FriasCamille/proyecto_final_invernadero/README.md

# Proyecto final Fundamentos de Sistemas Embebidos 2025-1
 proyecto_final_invernadero
# Universidad Nacional Autónoma de México
## Facultad de Ingeniería
 Grupo: 02
# Autores:
- Cruz Calderón Jorge Luis
- Frías Hernández Camille Emille Román
- Sánchez Estrada Angel Isaac
