FriasCamille/proyecto_final_invernadero/log/Proyecto_Final_Invernadero.pdf

# Proyecto final Control de invernadero

Cruz Calderón Jorge Luis, Frías Hernández Camille Emille Román, Sánchez Estrada Angel Isaac

El presente proyecto busca gestionar de manera eficiente las condiciones internas del entorno controlado, asegurando la regulación de temperatura, la irrigación y el flujo de aire, mediante la integración de sensores y actuadores.

El sistema contará con funciones automatizadas, como el encendido y apagado del sistema de irrigación, el control de temperatura a través de un controlador PID, y la administración de la velocidad del ventilador mediante señales PWM. Adicionalmente, se implementará un servidor web que permitirá el acceso remoto a las funciones del invernadero y la consulta de gráficas históricas que registran las variables monitoreadas y las acciones realizadas.

El proyecto incluye tanto el diseño de hardware, que comprende la conexión de sensores y actuadores, como el desarrollo de software para la programación del sistema embebido, garantizando una solución práctica, robusta y accesible para usuarios con conocimientos básicos en electrónica y sistemas embebidos.

## 1. Objetivos

Diseñar e implementar un sistema embebido que permita la supervisión y control remoto de un invernadero más enfocado en las plantas suculentas, integrando sensores y actuadores para gestionar de manera precisa las variables ambientales internas.

Desarrollar una solución de software y hardware que incorpore un controlador PID para regular la temperatura, así como señales PWM para administrar la velocidad del ventilador, asegurando un funcionamiento eficiente y confiable.

Proveer un sistema de visualización de datos históricos mediante gráficas almacenadas, además de un servidor web local, para facilitar el análisis y la toma de decisiones sobre el funcionamiento del invernadero.

## 2. Antecedentes

Adaptabilidad y Eficiencia de las Suculentas en Espacios Reducidos: Diseño y Gestión de un Invernadero Controlado

En este proyecto se plantea usar la planta suculenta debido a los cuidados que requiere, ya que se ca-racteriza por su bajo consumo de recursos, tanto naturales como de mantenimiento. Esta elección resulta particularmente adecuada para un entorno de estudiante o en espacios reducidos, como un departamento, donde el tiempo y los recursos disponibles para el cuidado de plantas suelen ser limitados.

Las suculentas, gracias a su capacidad natural para almacenar agua en sus hojas, tallos o raíces, prosperan con un riego esporádico y no necesitan de un sustrato complejo, lo que facilita su cuidado. Además, estas plantas toleran ambientes con baja humedad relativa, entre el 10 % y el 30 %, y se adaptan fácilmente a invernaderos con condiciones controladas, sin requerir sistemas complicados de irrigación

Página 1 de 32 o ventilación. Estas características las hacen ideales para espacios donde la optimización de recursos es crucial (Nabors, 2006).

El diseño de un invernadero para plantas suculentas debe considerar los aspectos clave de ventilación, irrigación y control de temperatura, ya que estos influyen directamente en su crecimiento.

Las suculentas requieren una iluminación intensa para un crecimiento óptimo. El uso de una lámpara incandescente de 100W proporciona la intensidad lumínica necesaria. Sin embargo, estas lámparas emiten una cantidad significativa de calor, lo que puede dañar las plantas si se colocan demasiado cerca. Por lo que, una lámpara incandescente de 100W puede colocarse a una distancia de 30cm de las plantas, proporcionando la intensidad lumínica adecuada sin el riesgo de sobrecalentamiento (Saltón Verde, 2022).

Las suculentas prosperan en un rango de temperatura diurna de 21°C a 29°C y nocturna de 10°C a 15°C. Es esencial monitorear la temperatura dentro del invernadero, especialmente al utilizar fuentes de luz que emiten calor. El uso de lámparas incandescentes puede elevar la temperatura interna, por lo que es crucial asegurarse de que no exceda los 30°C para evitar el estrés térmico en las plantas (Garvillo, 2023).

Una ventilación adecuada es vital para mantener niveles óptimos de temperatura y humedad, así como para prevenir la acumulación de patógenos. La instalación de dos ventiladores en la parte superior del invernadero ayudará a promover la circulación del aire y a disipar el calor generado por la lámpara. Es recomendable que los ventiladores operen de manera continua o en intervalos regulares para asegurar una renovación constante del aire (Bribiesca, R., 2020).

El método de riego subterráneo es una técnica que suministra agua directamente al sistema radicular mediante emisores enterrados. Este método minimiza pérdidas por evaporación, lo que lo convierte en una opción eficiente para las suculentas, especialmente en ambientes controlados como invernaderos. Al permitir que el agua llegue directamente a las raíces, este sistema evita el desperdicio hídrico, una ventaja significativa en regiones con limitaciones de agua (Lucas et al., 2015).

Protocolos

El bus 1-Wire es un protocolo de comunicación serial desarrollado por Dallas Semiconductor, ahora parte de Maxim Integrated, que permite la interconexión de dispositivos digitales utilizando una única línea de datos y una referencia a tierra común. En una configuración maestro-esclavo, el dispositivo maestro controla la comunicación y puede interactuar con múltiples esclavos, cada uno con una dirección única de 64 bits, lo cual facilita la identificación y el acceso a cada dispositivo en el bus (Linke, 2008).

Por otro lado, el bus I2C, desarrollado por Philips, permite la interconexión de múltiples dispositivos mediante dos líneas, SDA (datos) y SCL (reloj). Este protocolo soporta varios modos de velocidad y puede conectar múltiples dispositivos maestros y esclavos, cada uno identificado por una dirección única de 7 o 10 bits (NXP Semiconductors, 2021).

Componentes

El sensor DS18B20 es un sensor de temperatura digital que utiliza el bus 1-Wire para comunicarse con dispositivos maestros como la Raspberry Pi. Este sensor, que tiene un rango de temperatura de -55°C a +125°C y una precisión de ±0.5°C, se puede alimentar directamente desde la línea de datos, simplificando el diseño del sistema (Maxim Integrated, 2015).

El TRIAC es un dispositivo semiconductor utilizado para controlar flujos de baja potencia en un circuito CA. Los TRIACS pueden conducir en ambos sentidos de la corriente, permitiendo la modulación del ciclo completo de la señal alterna (Boylestad y Nashelsky, 2015).

El IRLZ44N es un transistor MOSFET de canal N diseñado principalmente para aplicaciones de conmutación y control de potencia. Este componente se destaca por su capacidad para manejar altas corrientes de hasta 47 amperios y su baja resistencia en estado de conducción, lo que lo hace eficiente

Página 2 de 32 en términos de disipación de energía. Gracias a su voltaje de umbral bajo, puede ser controlado directamente mediante señales de nivel lógico, lo cual facilita su integración en circuitos digitales (Philips Semiconductors, 1999).

El MOC3021 es un optoacoplador diseñado para aislar eléctricamente circuitos de control de corriente directa y dispositivos de corriente alterna. Este dispositivo emplea un diodo emisor de infrarrojos y un interruptor bilateral de silicio que, juntos, permiten controlar cargas como motores, lámparas o solenoides. Una de sus principales ventajas es su capacidad para bloquear voltajes de hasta 400 voltios, proporcionando un aislamiento seguro de hasta 5300 voltios RMS (Fairchild Semiconductor, 2003).

Por otro lado, los optoacopladores o optoaisladores son dispositivos que permiten la transmisión de señales entre dos circuitos. El dispositivo consta de un LED y un fotodiodo, donde el LED emite luz en señal de entrada activando el fotodiodo de salida. El optoacoplador 4N25 es un dispositivo electrónico ampliamente utilizado que combina un diodo emisor de luz (LED) y un fototransistor NPN en un encapsulado DIP de 6 pines, con el propósito de proporcionar aislamiento eléctrico entre dos circuitos. Entre sus características principales destacan su capacidad de manejar tensiones de colector-emisor de hasta 70 V, así como una corriente de entrada típica de 10 mA para activar el LED interno (Mishra y Singh, 2018; Vishay Semiconductors, 2010).

El sensor de humedad del suelo FC-28 es un dispositivo ampliamente utilizado para medir la humedad en aplicaciones agrícolas, como los sistemas de riego automatizados en invernaderos. Este sensor opera mediante la medición de la conductividad eléctrica entre sus electrodos, la cual varía según el contenido de agua en el suelo. Ofrece tanto una salida analógica como una digital, lo que facilita su integración con microcontroladores. Su implementación permite monitorear continuamente la humedad del suelo, lo que resulta fundamental para optimizar el uso del agua y evitar problemas como el riego excesivo o la deshidratación de las plantas (Marrero Ramírez et al., 2021).

Control de un foco incandescente de 100 W mediante PID

El control PID es ampliamente utilizado para regular dispositivos que requieren precisión, como un foco incandescente de 100 W. Este sistema ajusta la potencia en función de la diferencia entre el valor deseado y el valor medido, minimizando el error actual y acumulado. El control PID ofrece una respuesta dinámica y estable al regular variables como la temperatura, gracias a su capacidad de ajustar automáticamente los parámetros proporcional, integral y derivativo. En este caso, la señal del PID puede controlar un TRIAC para modular gradualmente la intensidad lumínica del foco y, en consecuencia, la temperatura generada (Dorf y Bishop, 2011).

Control de los ventiladores mediante PWM

La Modulación por Ancho de Pulso (PWM) es una técnica eficiente para controlar dispositivos como ventiladores. El PWM permite variar la velocidad de un motor ajustando el ciclo de trabajo de una señal digital, lo que regula la potencia entregada sin pérdidas significativas de energía. En este caso, la frecuencia de la señal debe seleccionarse adecuadamente para evitar ruido y garantizar un funcionamiento suave. Este método se implementa fácilmente mediante un microcontrolador y un transistor o driver de motor, permitiendo ajustar la velocidad del ventilador según los requerimientos del sistema (Rashid, 2013).

## Lista de Componentes

Se asume que el alumno cuenta con una Raspberry Pi con sistema operativo Raspberry Pi OS Lite (2023–05–03 o anterior) e intérprete de Python instalado. Se aconseja encarecidamente el uso de Git como programa de control de versiones.

Dispositivos principales

1 Raspberry Pi Placa Base Modelo B / 8GB

Página 3 de 32

1 microcontrolador RP2040 (Raspberry Pico) con firmware MicroPython precargado

Accesorios y conectividad

1 cable USB-C con soporte para datos

1 conector DIL con cable plano tipo listón para el GPIO de la Raspberry Pi

Cables y conectores varios

10 Borneras de 2

2 Borneras de 3

Alimentación y energía

1 fuente de alimentación regulada a 5V y al menos 2 amperios de salida

1 fuente de alimentación regulada a 12V y al menos 1 amperio de salida

Resistencias

1 resistencia de 68 kΩ (
1
4 Watt)

4 resistencias de 10 kΩ (
1
4 Watt)

1 resistencia de 4.7 kΩ (
1
4 Watt)

1 resistencia de 1 kΩ (1 Watt)

4 resistencias de 470 Ω (
1
4 Watt)

1 resistencia de 330 Ω (
1
4 Watt)

Componentes electrónicos adicionales

1 TRIAC BT137

4 diodos 1N4007 o puente rectificador equivalente

1 optoacoplador 4N25

1 optoacoplador MOC 3021

1 LED ultrabillante de 5 mm

3 transistores IRLZ44

Sistema de ventilación y enfriamiento

2 ventiladores plásticos 510-740 de 4”12V RAD (8x8x2.5 cm)

Sistema de bombeo

1 mini bomba de agua 6-12V (3W, 0.3Mpa)

4 metros de manguera para bomba de agua de 0.9 a 1 cm

Página 4 de 32

Iluminación

1 foco incandescente de 100W (NO AHORRADOR NI LED)

1 socket para foco incandescente

Otros

1 protoboard o circuito impreso equivalente

1 sensor de humedad del suelo FC-28 Higrómetro

4 sensores de temperatura DS18B20

## 3. Descripción del funcionamiento de los componentes

Control del foco

Al estar trabajando con un circuito que requiere una parte en AC y otra en DC, es necesario rectificar la señal. Para ello se utilizaron diodos 1N4007, debido a su capacidad de soportar hasta 1000 V, lo cual es más que suficiente para la señal de AC en México, que es de 120 V. Por otro lado, el amperaje especificado para ellos es de un máximo de 1 A. Al usar un foco de 100 W y despejar de la fórmula I =

P
V

, obtenemos
un resultado de menos de un amperio, 0,833, por lo que estos diodos son ideales para la rectificación de esta señal.

Se utiliza un TRIAC (Triode for Alternating Current) que permite conmutar el paso de la corriente en un circuito de AC. En este caso, este circuito enciende el foco, cumpliendo la función de un interruptor, similar a un transistor en DC o a un relé, pero con la ventaja de ser más duradero y de poder funcionar con una señal de un microcontrolador, incluso con una corriente muy pequeña, permitiendo su activación controlada.

Con el fin de aislar correctamente las señales de AC y DC, se utilizaron dos optoacopladores: el 4N25 y el MOC3021. De esta forma, podemos detectar el cruce por cero de la señal rectificada. Asimismo, se puede enviar una señal al tiristor para activarlo y permitir el paso de la corriente al foco. El MOC3021 fue utilizado por tener un tiristor interno que le permite manejar los cambios de fase de una señal de AC sin perjudicar su funcionamiento, de forma que puede mandar una pequeña señal de AC al TRIAC, que manejará la señal directa de AC. Por su parte, el 4N25, al tener un circuito simple con un LED y un fototransistor, permite que el microcontrolador pueda detectar cada vez que el LED se apague, lo cual indica que la señal ha pasado por cero.

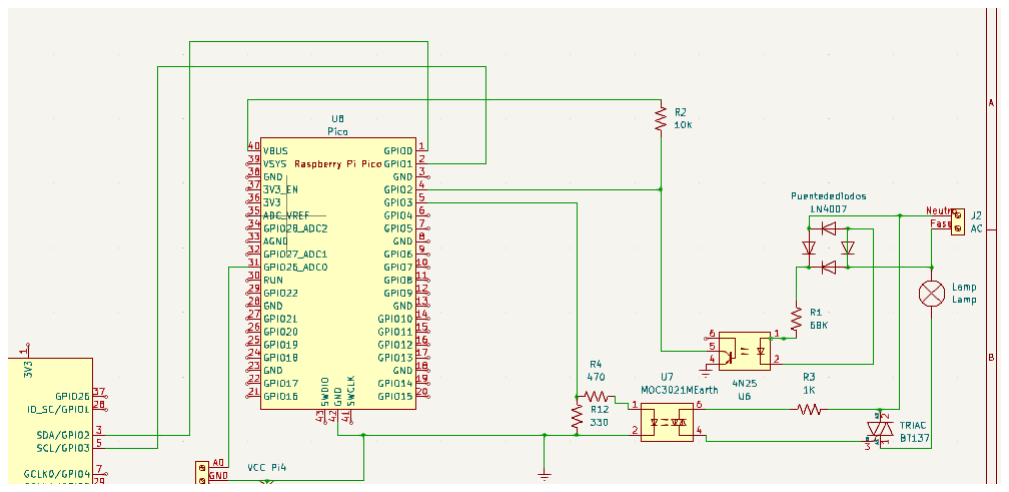
[picture p1: figure]

Figura 1: Circuito de control de foco

Control de motores

Los motores son actuadores que requieren una gran corriente para vencer la inercia y comenzar su trabajo. Con el fin de no exigir demasiado al microcontrolador y evitar dañarlo, se utilizan transistores

Página 5 de 32 en modo interruptor con una fuente externa que pueda satisfacer las necesidades de los actuadores, como amperajes relativamente altos (1 A) y un voltaje diferente al de salida de los microcontroladores.

Para este circuito se utilizaron transistores IRLZ44, ya que los motores de los ventiladores requieren 12 V DC y un amperaje de 220 mA, según la hoja de especificaciones. Por lo tanto, se empleó un transistor en modo interruptor para cada ventilador, así como para la bomba de 12 V y 250 mA. Para proteger al microcontrolador, y aprovechando la capacidad de los transistores de activarse con una señal de bajo amperaje, se utilizó una resistencia de 470 Ω y otra resistencia de 10 kΩ entre el source y el gate para evitar ruido en la señal, asegurando que se apaguen y enciendan según lo deseado.

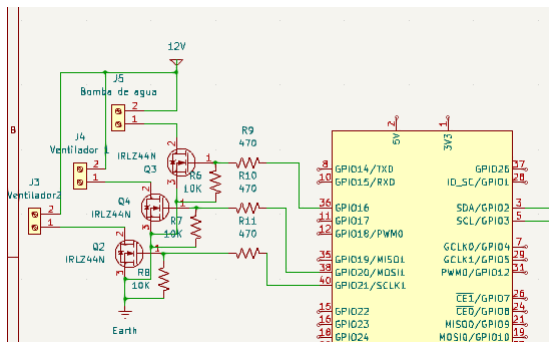
[picture p2: figure]

Figura 2: Circuito del control de los motores

Sensado

El sistema incluye dos tipos principales de sensores: sensores de temperatura y un sensor de humedad.

Los sensores de temperatura son del tipo DS18B20, que operan mediante el protocolo One Wire. Esto permite realizar varias mediciones usando solamente un pin de señal, sin la necesidad de preocuparse por la sincronización de datos ni por la conversión analógica a digital. Estos sensores utilizan una resistencia de 470 Ω conectada a VCC, según lo recomendado en la hoja de datos.

Por su parte, para la medición de humedad se utilizó un higrómetro FC-28, que permite obtener lecturas tanto analógicas como digitales. Esto facilita una mejor aproximación de la humedad dentro del invernadero. Además, su cableado es simple, utilizando únicamente un pin ADC proporcionado por la Pico, obteniendo un porcentaje de humedad útil para decidir el riego.

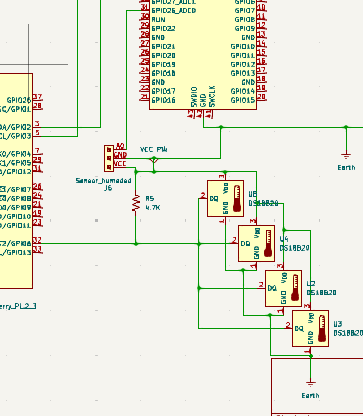
[picture p3: figure]

Figura 3: Circuito del control de los sensores

Página 6 de 32

## 4. Descripción del funcionamiento de la tarjeta controladora y circuito microcontrolador

En este sistema se emplean dos tarjetas: una Raspberry Pi 4 y una Raspberry Pi Pico, cada una con funciones específicas dentro del diseño.

La Raspberry Pi 4 se encarga de ejecutar los procesos principales, incluyendo el cálculo y la activación de los actuadores. Esta tarjeta realiza los cálculos del error y las correcciones correspondientes para el control PID, además de gestionar el sensado de los termómetros mediante el protocolo One Wire. También es responsable de la interfaz gráfica para el servidor, permitiendo la visualización y el control centralizado de la mayoría de las señales del sistema.

Por otro lado, la Raspberry Pi Pico tiene como función principal la gestión de señales críticas enviadas a la Raspberry Pi 4. Esto incluye la detección del cruce por cero en el circuito del foco y el envío de la señal de retorno desde el dimmer al MOC. Gracias a sus puertos ADC, la Raspberry Pi Pico también realiza la medición de los niveles de humedad, proporcionando una señal digital (0 o 1) a la Raspberry Pi 4 para su procesamiento, contribuyendo así al comportamiento automatizado del sistema.

## 5. Cuidado de la salud y advertencias de riesgos

El diseño e implementación de un sistema de invernadero utilizando componentes electrónicos y eléctricos requiere adoptar medidas de seguridad rigurosas para proteger tanto al usuario como al equipo.

En primer lugar, se deben manipular con precaución las fuentes de alimentación y los dispositivos conectados a la corriente eléctrica. Nunca se debe operar con las manos húmedas ni en superficies mojadas, ya que esto aumenta significativamente el riesgo de electrocución. Asimismo, es fundamental utilizar protectores contra sobrecargas para evitar picos de voltaje que puedan dañar el sistema o causar incendios. Los cables y conectores deben revisarse regularmente para garantizar que no presenten desgaste o daño que pueda resultar en cortocircuitos o pérdida de funcionalidad.

El foco incandescente de 100W puede representar un riesgo, ya que alcanza temperaturas elevadas durante su operación. El contacto directo con este elemento puede causar quemaduras graves, y su proximidad a materiales inflamables aumenta el peligro de incendio. Por ello, se debe instalar en un soporte resistente al calor y mantenerlo alejado de otros componentes sensibles al calor, como sensores o cables.

Los sistemas de ventilación y bombeo implican riesgos mecánicos y eléctricos. Los ventiladores en funcionamiento pueden causar lesiones si se tocan accidentalmente, mientras que la bomba de agua, al operar con líquidos, presenta el peligro de cortocircuitos si las conexiones eléctricas no están adecuadamente aisladas de la humedad. Es recomendable utilizar carcasas protectoras para los ventiladores y garantizar que las conexiones eléctricas estén adecuadamente aisladas.

Trabajar con estos dispositivos requiere un entorno limpio, seco y bien ventilado, así como un cono-cimiento básico de las especificaciones técnicas de cada componente. Tener acceso a un interruptor de seguridad para desactivar rápidamente el sistema en caso de emergencia, además de un kit de primeros auxilios, puede ser crucial para abordar cualquier eventualidad.

## 6. Información sobre el cuidado de los componentes electrónicos delicados

El cuidado adecuado de los componentes electrónicos es fundamental para garantizar su correcto funcionamiento y prolongar su vida útil, especialmente en proyectos donde se utilizan dispositivos sensibles como los incluidos en el sistema de invernadero. En primer lugar, es necesario considerar las descargas electrostáticas (ESD), ya que estas representan un riesgo significativo para componentes como la Raspberry Pi y el microcontrolador RP2040. Para mitigar este riesgo, se recomienda trabajar en superficies

Página 7 de 32 antiestáticas, utilizar una pulsera antiestática conectada a tierra y manipular los dispositivos únicamente por los bordes, evitando el contacto directo con pines o terminales expuestos.

Los TRIAC, optoacopladores y transistores requieren un manejo delicado, asegurando siempre que sus terminales estén aislados y protegidos contra picos de corriente. Para ello, se sugiere utilizar fusibles o circuitos de protección adicionales. El sistema de ventilación y bombeo también presenta cuidados específicos. Los ventiladores deben mantenerse libres de polvo y montados de manera firme para evitar vibraciones que puedan dañar otros componentes. Asimismo, la bomba de agua debe operarse con precaución, evitando su funcionamiento en seco y asegurando que las conexiones eléctricas estén debidamente selladas para prevenir filtraciones y cortocircuitos.

El foco incandescente debe mantenerse a una distancia prudente de los componentes electrónicos para evitar daños por exposición al calor. Además, debe evitarse su manipulación mientras está encendido o caliente, debido al riesgo de quemaduras. Por último, el sensor de humedad del suelo FC-28 requiere una limpieza regular para evitar corrosión y debe utilizarse dentro de sus parámetros operativos, evitando inmersiones profundas en agua, ya que podrían dañarlo.

## 7. Configuración de la tarjeta controladora y microcontrolador

Para la configuración de los protocolos de comunicación I2C y One-Wire en la Raspberry Pi, se siguieron los pasos descritos a continuación:

1. Acceder al menú de configuración de la Raspberry Pi utilizando el comando:

sudo raspi-config

2. Dentro del menú de configuración, seleccionar la opción Interface Options.
3. Habilitar el protocolo I2C seleccionando la opción I2C y confirmando su activación.
4. Repetir el proceso para habilitar el protocolo One-Wire seleccionando la opción One-Wire.
5. Guardar los cambios y salir del menú de configuración.
6. Reiniciar la Raspberry Pi para aplicar los cambios ejecutando el comando:

sudo reboot

7. Verificar que los protocolos estén habilitados correctamente:

Para I2C, instalar la utilidad i2c-tools si aún no está instalada:

sudo apt-get install -y i2c-tools

Luego, utilizar el comando:

i2cdetect -y 1

Esto mostrará una tabla con los dispositivos conectados en el bus I2C.

Para One-Wire, verificar la presencia del archivo de dispositivo asociado en el sistema de archivos en la ruta:

/sys/bus/w1/devices

Página 8 de 32

Donde los sensores o dispositivos conectados deberían aparecer listados.

Con estos pasos, los protocolos I2C y One-Wire quedan configurados y listos para su uso en la Raspberry Pi. Esto permite la comunicación con los sensores de temperatura y la Raspberry Pi Pico.

### 7.1. Inicio automático

Para la ejecución automática, se debe acceder nuevamente a la configuración de la Raspberry Pi utilizando el comando:

sudo raspi-config

De ahí se elegirá la opción System Options → Boot/Autologin y seleccionar la opción que mejor se ajuste a las necesidades.

Se reiniciará para guardar las configuraciones y, una vez que vuelva a encender, se creará un archivo bash que ejecutará el archivo del proyecto con un código similar al siguiente:

#!/bin/bash

# Navegar al directorio donde está el archivo final.py cd /ruta/del/programa

# Ejecutar el programa en Python

python3 programa.py

# Fin del script

exit 0

Se le otorgarán permisos de ejecución con:

chmod +x /home/pi/miprograma.sh

Luego, se modificará el archivo rc.local agregando la siguiente línea antes del exit del archivo:

/home/pi/programa.sh

## 8. Desarrollo de los componentes de software

Control del sistema de irrigación y humedad

Cruz Calderón Jorge Luis

Como se investigó en los antecedentes, la planta suculenta es capaz de soportar humedades bajas de alrededor del 10 % y 30 %. Y, en base a esto, se creó la función controlar humedad en la Pico, que gestiona el nivel de humedad mediante la activación o desactivación de una salida según los valores obtenidos del sensor. En primer lugar, evalúa si el porcentaje de humedad es inferior al umbral mínimo (10 %).

Si esta condición se cumple, activa la salida a un estado alto (1) y emite un mensaje indicando que la humedad es baja. En cambio, si la humedad excede el umbral máximo (30 %), desactiva la salida estableciendo un estado bajo (0). Finalmente, si la humedad se encuentra dentro del rango aceptable, la función asegura que la salida permanezca desactivada. De esta forma, el sistema garantiza el control eficiente de la humedad, manteniéndola dentro de los límites especificados para una suculenta.

1 def controlar_humedad ( humedad , pin , min_humedad =10 , max_humedad =30) :

Página 9 de 32

2 | if humedad < min_humedad :
3 | pin . value (1)
4 | print (" Humedad baja . Activando salida ... ")
5 | elif humedad > max_humedad :
6 | pin . value (0)
7 | print (" Humedad alta . Desactivando salida ... ")
8 | else :
9 | print (" Humedad dentro del rango adecuado .")
10 | pin . value (0)

Código 1: Función para el control de humedad

En la Raspberry Pi, la función solve humidity es responsable de gestionar la activación del sistema de irrigación en función de una señal de entrada detectada en el pin denominado PIN INTERRUPT. En primer lugar, verifica si dicho pin se encuentra en un estado alto, indicando la necesidad de iniciar el riego. En este caso, la función activa el pin de salida para habilitar el sistema de irrigación, manteniéndolo encendido durante un segundo utilizando un temporizador o función de retardo. Posteriormente, desactiva el pin de salida para detener la irrigación.

Si, por el contrario, la señal en PIN INTERRUPT está en estado bajo, la función garantiza que el sistema de irrigación permanezca apagado al desactivar el pin de salida. De esta manera, la función asegura un control eficiente y reactivo del riego, basado en las condiciones detectadas por el sensor.

1 | def solve_humidity () :
2 | if GPIO . input ( PIN_INTERRUPT ) == GPIO . HIGH :
3 | GPIO . output ( PIN_OUTPUT , GPIO . HIGH )
4 | print (" I n t e r r u p c i n detectada , PIN 16 en ALTO ")
5 | time . sleep (1)
6 | GPIO . output ( PIN_OUTPUT , GPIO . LOW )
7 | else :
8 | GPIO . output ( PIN_OUTPUT , GPIO . LOW )

Código 2: Función activar la irrigación

Control de temperatura del invernadero utilizando PID a través del foco incandescente

Frías Hernández Camille Emille Román y Sánchez Estrada Angel Isaac ´

El sistema implementa un controlador PID para regular la temperatura del invernadero ajustando la potencia del foco incandescente a través del protocolo I²C.

La clase PIDController es el núcleo del sistema de control proporcional-integral-derivativo (PID). Utiliza la fórmula:

salida = Kp · error + Ki

- integral + Kd · derivada

Donde:

Kp: Coeficiente proporcional.

Ki: Coeficiente integral.

Kd: Coeficiente derivativo.

error: Diferencia entre el setpoint y el valor actual.

integral: Acumulación de errores pasados.

derivada: Cambio del error con respecto al tiempo.

Página 10 de 32 calculate(): Ajusta la potencia del sistema y la limita entre 0 % y 100 %.

1 | def calculate ( self , setpoint , actual_value , dt =3.0) :
2 | error = setpoint - actual_value
3 | self . integral += error * dt
4 | derivative = ( error - self . previous_error ) / dt
5 | output = self . Kp * error + self . Ki * self . integral + self . Kd * derivative
6 | self . previous_error = error
7 | # Limitar salida entre 0 % y 100 %
8 | output = max (0 , min (100 , output ))
9 | return round ( output )

Código 3: Actualización de errores

write power(pwr): Envía el valor de potencia al dispositivo esclavo a través de I²C.

1 | def write_power ( pwr ):
2 | try :
3 | data = struct . pack (’<f’, pwr )
4 | msg = smbus2 . i2c_msg . write ( SLAVE_ADDR , data )
5 | i2c . i2c_rdwr ( msg )
6 | except Exception as e:
7 | print (f" Error en la escritura I2C : {e}")

Código 4: Envío de la potencia

control temperature(setpoint): Lee la temperatura actual, calcula la potencia ajustada usando el controlador PID y la envía al esclavo.

1 | def control_temperature ( setpoint ):
2 | pid_controller = PIDController () | # Usa las constantes predeterminadas
3 | try :
4 | actual_temp = read_temperature ()
5 | if actual_temp is None :
6 | print ("No se obtuvo una lectura v l i d a . Intentando de nuevo ... ")
7 | return None

8
9 | adjusted_power = pid_controller . calculate ( setpoint , actual_temp )
10 | write_power ( adjusted_power )

11
12 | print (f" Setpoint : { setpoint } C | | Actual : { actual_temp :.2 f} C | | Potencia :
| { adjusted_power} %")
13 | return adjusted_power
14 | except Exception as e:
15 | print (f" Error en el control PID: {e}")
16 | return None
Código 5: Método para utilizar el PID

El control del foco está dado por un dispositivo esclavo I²C que controla un dimmer para ajustar la intensidad de un foco, además de monitorear la humedad en un hilo separado.

Se utiliza un programa PIO (Programmable I/O) para sincronizar el control del foco con el cruce por cero de la corriente alterna, ajustando el retraso según la potencia recibida.

El dispositivo esclavo I²C, implementado con la librería i2cslave.py, recibe valores de potencia, los valida y ajusta el brillo del foco utilizando el dimmer.

Se emplea la librería de Mauricio Matamoros para usar la Raspberry Pi Pico como dispositivo esclavo I

2C.

De forma que el flujo es el siguiente:

1. El script PID.py calcula el nivel de potencia necesario para mantener la temperatura deseada y lo envía al esclavo I²C.

Página 11 de 32

2. El script main.py recibe el valor de potencia y ajusta el brillo del foco mediante el dimmer.
3. Simultáneamente, un hilo de monitoreo mide la humedad, garantizando la operación concurrente del sistema.

Control de potencia del ventilador mediante PWM

Cruz Calderón Jorge Luis y Sánchez Estrada Angel Isaac

Para ajustar la potencia de los ventiladores mediante PWM, se creó la función set motor power. Cuando se llama a esta función, primero verifica que el valor de potencia, representado por el parámetro power, esté comprendido entre 0 y 100. Este valor se mide en porcentaje.

0 % significa que el motor estará completamente apagado.

100 % significa que el motor estará funcionando a toda su potencia.

Si el valor es válido, la función utiliza el comando ChangeDutyCycle del objeto pwm. Este comando ajusta el ciclo de trabajo, que es el porcentaje del tiempo que la corriente está .encendida”durante un período de tiempo.

Si power es 50, el motor recibirá corriente la mitad del tiempo y girará a la mitad de su potencia máxima.

Si power es 100, el motor recibirá corriente todo el tiempo y girará a su máxima velocidad.

Si el valor de power está fuera del rango permitido, la función mostrará un mensaje de error para indicar que la potencia debe ser un número entre 0 y 100.

1
2 def set_motor_power ( pwm , power ) :

3
4 | if 0 <= power <= 100:
5 | pwm . ChangeDutyCycle ( power )
6 | else :
7 | print (" Error : La potencia debe estar entre 0 y 100. ")

Código 6: Manejo de la potencia del ventilador mediante PWM

Programado de ciclos de temperatura e irrigado

Cruz Calderón Jorge Luis

La función get setpoint determina el valor de la temperatura deseada (setpoint) que será utilizado en el sistema de control térmico. Su funcionamiento se basa en dos posibles escenarios: el uso de un valor personalizado definido por el usuario o un valor predeterminado que varía según el ciclo diurno o nocturno.

En primer lugar, la función verifica si existe un valor personalizado asignado a la variable global custom setpoint. Si dicho valor no es nulo, la función retorna directamente este valor, dado que se asume que el usuario ha decidido establecer manualmente la temperatura deseada. Este comportamiento prioriza la configuración manual sobre la automática, permitiendo mayor flexibilidad.

En caso de que no se haya definido un valor personalizado, la función procede a calcular el setpoint basándose en la hora actual del sistema. Para ello, utiliza time.localtime().tm hour, que devuelve la hora en formato de 24 horas.

Si la hora está entre las 06:00 y las 20:00, se retorna un valor de 25 °C, que representa la temperatura predeterminada para el período diurno.

Página 12 de 32

Si la hora está fuera de este rango (20:00 a 06:00), se retorna un valor de 12.5 °C, que corresponde a la temperatura predeterminada para el período nocturno.

1 def get_setpoint () :

2
3 | global custom_setpoint
4 | if custom_setpoint is not None :
5 | return custom_setpoint

6
7 | current_hour = time . localtime () . tm_hour
8 | if 6 <= current_hour < 20: | # De 6:00 AM a 8:00 PM
9 | return 25.0 | # Temperatura diurna
10 | else : | # De 8:00 PM a 6:00 AM
11 | return 12.5 | # Temperatura nocturna
Código 7: Ciclo de temperatura

El sistema de irrigación no utiliza un ciclo fijo, sino un control dependiente del nivel de humedad del suelo. Si la tierra no está lo suficientemente húmeda, se enviará una señal que activará la irrigación. Cuando el sensor de humedad supere el 30 % o alcance una humedad adecuada, la irrigación se detendrá automáticamente.

Servidor web y gráfica con histórico de temperatura, irrigación y acciones tomadas

Frías Hernández Camille Emille Román y Sánchez Estrada Angel Isaac

Se realizó un código para el servidor el cual tuviera como objetivo el llamar a un html para darle formato a la página.

1 | class ControlServer ( BaseHTTPRequestHandler ):
2 | def _serve_ui_file ( self ):
3 | with open (" indexv2 . html ", "r") as f:
4 | content = f. read ()
5 | self . send_response (200)
6 | self . send_header (" Content - type ", " text / html ")
7 | self . end_headers ()
8 | self . wfile . write ( bytes ( content , "utf -8"))

Código 8: Llamada a HTML

Este mismo gestionará la llamada de funciones para darle la responsividad entre servidor y html leyendo su contenido y descripciones.

1 | if action == " update_setpoint ":
2 | # Actualiza el setpoint
3 | update_custom_setpoint ( float ( value ))
4 | # Inicia el sistema PID si no e s t | activo
5 | if not main_thread or not main_thread . is_alive () :
6 | main_thread = Thread ( target = main , daemon = True )
7 | main_thread . start ()
8 | response [" message "] = " Setpoint actualizado e inicio del control PID "

Código 9: Llamada a funciones a través del servidor

Finalmente el servidor se actualizará para mostrar las temperaturas que se irán actualizando conforme al tiempo de ejecución del mismo con el fin de que el usuario pueda monitorear en todo momento la temperatura.

1 | self . send_response (200)
2 | self . send_header (" Content - type ", " application / json ")
3 | self . end_headers ()
4 | self . wfile . write ( bytes ( json . dumps ( response ) , "utf -8"))
5 | except Exception as e:

Página 13 de 32

6 | print (" Error procesando la solicitud :", e )
7 | self . send_response (500)
8 | self . end_headers ()

Código 10: Actualización del servidor web

## 9. Integración de los componentes en una solución de software

Para crear una solución de software, los comportamientos del sistema se separaron en distintas funciones. Esto permite llamarlas según sea necesario para representar comportamientos programados según las necesidades específicas de las plantas propuestas. Asimismo, esta estructura facilita la integración con el servidor, ya que las funciones controlan cada actuador del sistema de forma modular.

También se desarrolló una función independiente para cada motor, lo que permite controlarlos de manera individual. Esto habilita comportamientos más complejos y específicos según las condiciones del sistema.

1 def encender_ambos_motores () :

2
3 | set_motor_power ( pwm_motor_1 , 100)
4 | set_motor_power ( pwm_motor_2 , 100)
5 | print (" Ambos motores encendidos al 100 %")

6
7 def apagar_ambos_motores () :

8
9 | set_motor_power ( pwm_motor_1 , 0)
10 | set_motor_power ( pwm_motor_2 , 0)
11 | print (" Ambos motores apagados ")

Código 11: Control de encendido y apagado del motor

El sistema permite realizar ajustes en la potencia del motor mediante PWM a una frecuencia fija. Esto reduce el ruido a cambio de una ligera pérdida de potencia.

1 def ajustar_potencia_motor ( motor , potencia ):

2
3 | set_motor_power ( motor , potencia )
4 | print (f" Potencia del motor ajustada a { potencia} %")

Código 12: Ajusta la potencia del motor

La lectura de los sensores se realiza a partir de los archivos correspondientes dentro de la carpeta w1/devices. Durante este proceso, se asegura que los valores sean válidos y que la lectura se haya realizado correctamente antes de agregarlos al cálculo del promedio.

1 def sensor_temperature ( sensor_file ):

2
3 | try :
4 | with open ( sensor_file , ’r’) as file :
5 | lines = file . readlines ()

6
7 | if lines [0]. strip () . endswith (’YES ’):
8 | temperature_data = lines [1]. split ("t=")
9 | if len ( temperature_data ) == 2:
10 | temperature_c = float ( temperature_data [1]) / 1000.0
11 | return temperature_c
Código 13: Lectura de la temperatura

## 10. Link del video demostrativo

Video demostrativo (https://youtu.be/c8E_DXlMjes?si=tbdNurkiDIHXOcme)

Página 14 de 32

## 11. Link del repositorio

GitHub (https://github.com/FriasCamille/proyecto_final_invernadero)

## 12. Conclusiones

Cruz Calderón Jorge Luis:

El desarrollo del invernadero representó un reto que abarcó desde el diseño y ensamblaje físico de la maqueta hasta la implementación de funciones para su correcto funcionamiento. Basándonos en una investigación previa sobre las necesidades específicas de las suculentas, logramos establecer ciclos diurnos y nocturnos óptimos, así como un control eficiente de la humedad mediante sensores. Aunque no se implementó un ciclo estricto de irrigación, el sistema diseñado responde automáticamente a las lecturas del sensor de humedad, garantizando un uso eficiente del agua.

El proyecto destacó por la integración de múltiples componentes, como el control de temperatura mediante un sistema PID y la regulación del flujo de los ventiladores a través de PWM, permitiendo crear un entorno óptimo para el desarrollo de las suculentas.

Uno de los principales desafíos durante el desarrollo del proyecto fue el manejo y la integración adecuada de los diversos componentes electrónicos, como MOSFETs, optoacopladores y sensores. La precisión en la conexión y ensamblaje de estos elementos resultó crucial, ya que cualquier error podía generar fallas significativas en el sistema, ocasionando retrasos al identificar y corregir los problemas. Estas dificultades resaltaron la importancia de seguir estrictamente las especificaciones técnicas de cada componente y realizar pruebas constantes en cada etapa de ensamblaje.

Por otro lado, la implementación del servidor web fue otro desafío destacado. Implicó garantizar la integración adecuada entre las funciones del sistema y su representación en el servidor, lo que exigió una verificación constante de las conexiones para evitar fallos que comprometieran los circuitos y el funcionamiento general del sistema.

Frías Hernández Camille Emille Román:

Durante el desarrollo de esta actividad se implementó una solución al problema del invernadero, integrando tanto conocimientos de software como de hardware con el objetivo de diseñar un sistema sencillo y económico.

En la parte de hardware, el desarrollo fue relativamente sencillo, siendo el principal reto la disposi-ción física de los componentes. Un desafío particular fue el espacio limitado en el circuito de corriente alterna (AC), ya que la proximidad entre los pines de las borneras incrementaba el riesgo de un posible cortocircuito. Esto requirió especial cuidado en la organización y aislamiento de las conexiones.

Por otro lado, el desarrollo de los códigos necesarios para implementar comportamientos mínimos a nivel de señales resultó manejable. Este enfoque permitió realizar pruebas individuales de los distintos módulos, garantizando su correcto funcionamiento antes de proceder con la integración final. El comportamiento integrado fue ajustado específicamente a las necesidades de las suculentas, basándose en investigación previa.

La mayor cantidad de problemas se presentó durante la implementación del servidor web. Fue necesario adaptar las soluciones de software existentes para que fueran compatibles con la lógica y la arquitectura del servidor, lo que demandó ajustes significativos en el diseño.

Finalmente, las constantes del sistema fueron ajustadas adecuadamente para resolver la lenta transmisión de energía calorífica en el sistema. Esto implicó aumentar la ganancia proporcional en el controlador PID, permitiendo que el foco incrementara rápidamente su potencia y alcanzara eficientemente la temperatura deseada.

Página 15 de 32

Sánchez Estrada Angel Isaac:

En este proyecto se desarrolló un sistema de invernadero que integra conceptos clave vistos en clase, como el control de potencia mediante PID aplicado a un foco, controladores de irrigación, monitoreo de humedad y modulación por ancho de pulso (PWM) para ventiladores. Estas implementaciones permitie-ron no solo un manejo eficiente de los recursos, sino también la creación de un entorno óptimo para el crecimiento de plantas suculentas.

La elección de las suculentas fue particularmente adecuada debido a su resistencia y facilidad de cuidado, ya que demandan pocos recursos y prosperan en condiciones controladas con riegos esporádicos y un rango de temperaturas bien definido. La precisión de los sistemas implementados permitió incluso considerar la posibilidad de reproducir estas plantas de manera eficiente, maximizando los beneficios de un entorno monitoreado.

Uno de los mayores retos del proyecto fue el ensamblaje de los circuitos, incluyendo su soldado, pruebas y corrección de errores. Cualquier falla requería identificar y analizar las posibles causas, lo cual se evidenció especialmente en la configuración del módulo controlador del foco. A esto se sumaron los problemas derivados del código, como la gestión de delays, las configuraciones del servidor, y la correcta vinculación de funciones con los elementos desplegados en el HTML, incluyendo la integración de hojas de estilo en CSS. La verificación constante de cada componente y su interacción fue crucial para garantizar un sistema funcional.

Además, fue indispensable consultar las hojas de especificaciones de cada componente utilizado, como focos, ventiladores, resistencias y MOSFETs. Esto permitió entender sus características individuales y su comportamiento en conjunto, asegurando que todos los elementos interactuaran de manera adecuada y eficiente dentro del sistema. Sin este análisis detallado, habría sido imposible garantizar un funcionamiento seguro y óptimo del invernadero.

Sin duda, este proyecto representó un desafío integral que abarcó tanto el ensamblaje físico como la depuración y optimización de software. Aunque el proceso fue complejo y exigente, los conocimientos adquiridos fueron significativos. Reconozco, sin embargo, que aún hay áreas por mejorar, como la optimización del código, la depuración más eficiente y la gestión de hilos para un funcionamiento más fluido y sin retrasos.

## 13. Cuestionario

1. ¿Qué factores deben considerarse en el diseño de un invernadero para plantas suculentas? Los factores a considerar incluyen la ventilación, la iluminación, el riego y el control de temperatura.
2. ¿Cómo contribuye el sensor DS18B20 al monitoreo de temperatura en un sistema de invernadero? Este sensor digital mide temperaturas entre -55°C y +125°C con una precisión de ±0.5°C. Su diseño permite alimentarlo directamente desde la línea de datos, simplificando su integración en sistemas basados en microcontroladores como la Raspberry Pi.
3. ¿De qué trata el protocolo 1-Wire y cómo se relaciona con el sensor DS18B20? El protocolo 1-Wire es una interfaz serial que permite la comunicación entre dispositivos utilizando una sola línea de datos y una referencia a tierra. El sensor DS18B20 utiliza este protocolo para transmitir datos de temperatura al sistema maestro, simplificando el diseño del sistema.
4. ¿Qué papel desempeña el TRIAC en el control de dispositivos de corriente alterna dentro del invernadero? El TRIAC regula el flujo de corriente alterna, permitiendo controlar dispositivos como lámparas incandescentes. Su capacidad para modular el ciclo completo de la señal facilita la regulación de la intensidad lumínica y, en consecuencia, de la temperatura en el sistema de invernadero.
5. ¿Qué es el transistor MOSFET IRLZ44N y para qué aplicaciones es más adecuado? El IRLZ44N es un transistor MOSFET de canal N diseñado para aplicaciones de conmutación y control de

Página 16 de 32 potencia. Es adecuado para manejar altas corrientes, hasta 47 amperios, y su baja resistencia lo hace eficiente en términos de disipación de energía. Su capacidad para ser controlado mediante señales de nivel lógico facilita su integración en sistemas digitales.

## Referencias

Boylestad, R. L., & Nashelsky, L. (2015). Electronic Devices and Circuit Theory (11.a ed.). Pearson. Bribiesca, R. (2020). Manejo de la temperatura en el invernadero. Consultado el 12 de noviembre de 2024, desde https://agrofacto.com/manejo-temperatura-invernadero/
Dorf, R. C., & Bishop, R. H. (2011). Sistemas de Control Moderno (12ª). Pearson Educación. Consultado el 21 de noviembre de 2024, desde https://www.academia.edu/35915273/Sistemas de Control Moderno Richard Dorf (https://www.academia.edu/35915273/Sistemas_de_Control_Moderno_Richard_Dorf)
Fairchild Semiconductor. (2003). MOC3021 Datasheet. Consultado el 24 de noviembre de 2024, desde https://www.alldatasheet.es/datasheet-pdf/pdf/53870/FAIRCHILD/MOC3021.html Garvillo. (2023). La mejor temperatura para las suculentas: una guía para un control óptimo. Consultado el 12 de noviembre de 2024, desde https://garvillo.com/es/mejor-temperatura-para-suculentas/Linke, B. (2008, junio). Overview of 1-Wire Technology and Its Use [Maxim Integrated]. https://www.analog.com/media/en/technical-documentation/tech-articles/guide-to-1wire-communication--maxim-integrated.pdf (https://www.analog.com/media/en/technical-documentation/tech-articles/guide-to-1wire-communication--maxim-integrated.pdf)
Lucas, F. J., Martínez-Alvarez, V., & Valiente, M. (2015). ´ | Subsurface drip irrigation vs. surface drip
irrigation in tomato. Consultado el 12 de noviembre de 2024, desde https://repositorio.upct.es/server/api/core/bitstreams/52874a73-c7f9-4283-824d-9ab2ce4da923/content (https://repositorio.upct.es/server/api/core/bitstreams/52874a73-c7f9-4283-824d-9ab2ce4da923/content)
Marrero Ramírez, S., González Palau, I., León Segovia, M. A., & Suárez Vinueza, R. E. (2021). Control de humedad y consumo de agua en un invernadero. Ciencia, Universidad Técnica de Cotopaxi. Consultado el 20 de noviembre de 2024, desde https://www.academia.edu/80463745/Control de humedad y consumo de agua en un invernadero (https://www.academia.edu/80463745/Control_de_humedad_y_consumo_de_agua_en_un_invernadero)
Maxim Integrated. (2015). DS18B20 Programmable Resolution 1-Wire Digital Thermometer. Consultado el 15 de noviembre de 2024, desde https://www.analog.com/media/en/technical-documentation/data-sheets/DS18B20.pdf (https://www.analog.com/media/en/technical-documentation/data-sheets/DS18B20.pdf)
Mishra, M., & Singh, S. P. (2018). Power Electronics: Circuits, Devices and Applications. McGraw Hill Education.
Nabors, M. W. (2006). Introducción a la botánica (1.a ed.). Addison-Wesley. Consultado el 12 de noviembre de 2024, desde https://www.academia.edu/44352742/Introducci%C3%B3n a la Bot% C3%A1nica Murray W Nabors (https://www.academia.edu/44352742/Introducci%C3%B3n_a_la_Bot%C3%A1nica_Murray_W_Nabors)
NXP Semiconductors. (2021). UM10204 I2C-bus specification and user manual. Consultado el 16 de noviembre de 2024, desde https://www.nxp.com/docs/en/user-guide/UM10204.pdf
Philips Semiconductors. (1999). IRFZ44N Datasheet. Consultado el 24 de noviembre de 2024, desde https: //www.alldatasheet.com/datasheet - pdf/pdf/17807/PHILIPS/IRFZ44N.html?utm source= chatgpt.com (https://www.alldatasheet.com/datasheet-pdf/pdf/17807/PHILIPS/IRFZ44N.html?utm_source=chatgpt.com)
Rashid, M. H. (2013). Electrónica de Potencia: Circuitos, Dispositivos y Aplicaciones (4ª). Pearson Educación.
Saltón Verde. (2022). Calculadora de iluminación LED: Potencia, PPF, PPFD y más. Consultado el 12 de noviembre de 2024, desde https://saltonverde.com/calculadora-de-iluminacion-led/
Vishay Semiconductors. (2010). 4N25, 4N26, 4N27, 4N28: Optocoupler, Phototransistor Output, with Base Connection [Hoja de datos]. Consultado el 15 de noviembre de 2024, desde https://www.vishay.com/docs/83725/4n25.pdf

Página 17 de 32

## A. Programa Control

1 | import threading
2 | import RPi . GPIO as GPIO
3 | import time
4 | import logging
5 | from motorPWM import setup_motor , set_motor_power , cleanup
6 | from Temperature import read_temperature
7 | from PID import control_temperature , write_power
8 | from funciones import ciclo , update_custom_setpoint

9
10 | # C o n f i g u r a c i n del logging
11 | logging . basicConfig (
12 | filename =’ function_calls . log ’,
13 | level = logging . INFO ,
14 | format =’ %(asctime )s - %(message )s’
15 | )

16
17 | PIN_MOTOR_1 = 20
18 | PIN_MOTOR_2 = 21
19 | PIN_INTERRUPT = 26
20 | PIN_OUTPUT = 16

21
22 | # C o n f i g u r a c i n de GPIO
23 | GPIO . setmode ( GPIO . BCM )
24 | GPIO . setwarnings ( False )

25
26 | # C o n f i g u r a c i n de motores
27 | try :
28 | pwm_motor_1 = setup_motor ( PIN_MOTOR_1 )
29 | pwm_motor_2 = setup_motor ( PIN_MOTOR_2 )
30 | print (" Motores inicializados correctamente .")
31 | except Exception as e:
32 | print (f" Error al inicializar motores : {e}")
33 | pwm_motor_1 = pwm_motor_2 = None

34
35 | def motor_derecho ( potencia ) :
36 | if pwm_motor_1 :
37 | logging . info (f’ F u n c i n llamada : motor_derecho con potencia ={ potencia }’)
38 | set_motor_power ( pwm_motor_1 , potencia )
39 | else :
40 | logging . error (" pwm_motor_1 no inicializado .")

41
42 | def motor_izquierdo ( potencia ):
43 | if pwm_motor_2 :
44 | logging . info (f’ F u n c i n llamada : motor_izquierdo con potencia ={ potencia }’)
45 | set_motor_power ( pwm_motor_2 , potencia )
46 | else :
47 | logging . error (" pwm_motor_2 no inicializado .")

48
49 | def ambos_motore ( potencia ):
50 | if pwm_motor_1 and pwm_motor_2 :
51 | logging . info (f’ F u n c i n llamada : ambos_motore con potencia ={ potencia }’)
52 | set_motor_power ( pwm_motor_1 , potencia )
53 | set_motor_power ( pwm_motor_2 , potencia )
54 | else :
55 | logging . error (" Motores no inicializados .")

56
57 | def bomba ( senal ):
58 | logging . info (f’ F u n c i n llamada : bomba con senal ={ senal }’)
59 | if senal == 1:
60 | GPIO . output ( PIN_OUTPUT , GPIO . HIGH )
61 | else :
62 | GPIO . output ( PIN_OUTPUT , GPIO . LOW )

63
64 | def potencia_foco ( potencia ) :
65 | logging . info (f’ F u n c i n llamada : potencia_foco con potencia ={ potencia }’)
66 | write_power ( potencia )

67
68 def set_PID ( temp ):

Página 18 de 32

69 | logging . info (f’ F u n c i n llamada : set_PID con temp ={ temp }’)
70 | control_temperature ( temp )

71
72 | def temperatura () :
73 | logging . info (’ F u n c i n llamada : temperatura ’)
74 | return read_temperature ()

75
76 | def predeterminado () :
77 | logging . info (’Revirtiendo a ciclo de setpoint predeterminado ’)
78 | update_custom_setpoint ( None )

79
80 | def set_value ( temp ):
81 | if temp is not None and not (0 <= temp <= 100) :
82 | logging . warning ( f’Setpoint i n v l i d o : { temp }’)
83 | raise ValueError (" Setpoint debe estar entre 0 y 100. ")
84 | update_custom_setpoint ( temp )

Página 19 de 32

## B. Programa Funciones

1 | import threading
2 | import RPi . GPIO as GPIO
3 | import time
4 | from motorPWM import setup_motor , set_motor_power
5 | from Temperature import read_temperature
6 | from PID import control_temperature , PIDController

7
8 pid_controller = PIDController ( kp =3.0 , ki =2.5 , kd =1.5)

9
10 | # C o n f i g u r a c i n de GPIO
11 | PIN_MOTOR_1 = 20
12 | PIN_MOTOR_2 = 21
13 | PIN_INTERRUPT = 26
14 | PIN_OUTPUT = 16

15
16 | # Limpieza inicial para evitar conflictos
17 | GPIO . cleanup () | # Fuerza la limpieza de cualquier c o n f i g u r a c i n previa
18 | GPIO . setmode ( GPIO . BCM )
19 | GPIO . setup ( PIN_INTERRUPT , GPIO .IN , pull_up_down = GPIO . PUD_DOWN )
20 | GPIO . setup ( PIN_OUTPUT , GPIO . OUT )

21
22 | # Variables globales para PWM
23 | pwm_motor_1 = None
24 | pwm_motor_2 = None

25
26 | def initialize_pwm () :
27 | """ Inicializa los pines PWM con manejo de errores y v e r i f i c a c i n . """
28 | global pwm_motor_1 , pwm_motor_2

29
30 | try :
31 | # Limpia objetos PWM existentes si es necesario
32 | if pwm_motor_1 is not None :
33 | pwm_motor_1 . stop ()
34 | pwm_motor_1 = None
35 | if pwm_motor_2 is not None :
36 | pwm_motor_2 . stop ()
37 | pwm_motor_2 = None

38
39 | # Inicializa PWM solo si no e s t n configurados
40 | pwm_motor_1 = setup_motor ( PIN_MOTOR_1 )
41 | pwm_motor_2 = setup_motor ( PIN_MOTOR_2 )

42
43 | except RuntimeError as e:
44 | print (f" Error al inicializar PWM: {e}")
45 | GPIO . cleanup () | # Limpieza adicional en caso de error
46 | raise

47
48 | def cleanup_pwm () :
49 | """ Limpia los recursos PWM y GPIO . """
50 | global pwm_motor_1 , pwm_motor_2
51 | if pwm_motor_1 is not None :
52 | pwm_motor_1 . stop ()
53 | pwm_motor_1 = None
54 | if pwm_motor_2 is not None :
55 | pwm_motor_2 . stop ()
56 | pwm_motor_2 = None
57 | GPIO . cleanup ()

58
59 | # Nueva variable global para almacenar la temperatura personalizada
60 | custom_setpoint = None

61
62 | def get_setpoint () :
63 | global custom_setpoint
64 | if custom_setpoint is not None :
65 | return custom_setpoint | # Usar el valor personalizado si e s t | definido

66
67 | current_hour = time . localtime () . tm_hour
68 | if 6 <= current_hour < 20: | # De 6:00 AM a 8:00 PM

Página 20 de 32

69 | return 12.0 | # Temperatura diurna
70 | else : | # De 8:00 PM a 6:00 AM
71 | return 24.5 | # Temperatura nocturna

72
73 | def update_custom_setpoint ( value ):
74 | global custom_setpoint
75 | custom_setpoint = value if value is not None else None
76 | ciclo () | # Re - trigger control cycle with updated setpoint

77
78 | def solve_temp ( setpoint ):
79 | # initialize_pwm () | # Asegura que PWM e s t | inicializado antes de usarlo
80 | actual_temp = read_temperature ()
81 | if actual_temp < setpoint - 1: | # Por debajo del rango
82 | power = 20
83 | elif actual_temp > setpoint + 1: | # Por encima del rango
84 | power = 100
85 | else : | # Dentro del rango
86 | power = 20

87
88 | # Aplicar potencia a los motores
89 | set_motor_power ( pwm_motor_1 , power )
90 | set_motor_power ( pwm_motor_2 , power )

91
92 | def solve_humidity () :
93 | if GPIO . input ( PIN_INTERRUPT ) == GPIO . HIGH :
94 | GPIO . output ( PIN_OUTPUT , GPIO . HIGH )
95 | print (" I n t e r r u p c i n detectada , PIN 16 en ALTO ")
96 | else :
97 | GPIO . output ( PIN_OUTPUT , GPIO . LOW )

98
99 | def ciclo () :
100 | """
101 | Main control cycle for temperature and humidity .
102 | Dynamically adapts to the current setpoint .
103 | """
104 | setpoint = get_setpoint () | # Fetch dynamic or custom setpoint
105 | control_temperature ( setpoint , pid_controller ) | # PID temperature control
106 | solve_temp ( setpoint ) | # Adjust temperature based on the current setpoint
107 | solve_humidity () | # Handle humidity control

108
109 | if __name__ == " __main__ ":
110 | try :
111 | initialize_pwm () | # Inicializa PWM antes de usarlo
112 | while True :
113 | ciclo ()
114 | time . sleep (1) | # Evita que el ciclo consuma recursos en exceso
115 | except KeyboardInterrupt :
116 | print (" I n t e r r u p c i n detectada . Limpiando GPIO ... ")

Página 21 de 32

## C. Programa Interface

1 | <! DOCTYPE html >
2 | < html lang ="es">
3 | <head >
4 | < meta charset ="UTF -8" />
5 | < meta name =" viewport " content =" width =device -width , initial - scale =1.0 " / >
6 | < title > Control de Motores y Temperatura </ title >
7 | < style >
8 | body {
9 | font - family : Arial , sans - serif ;
10 | background : linear - gradient ( to right , #141 e30 , #243 b55);
11 | color : white ;
12 | text - align : center ;
13 | margin : 0;
14 | padding : 0;
15 | }
16 | h1 ,
17 | h2 {
18 | margin - top : 20 px ;
19 | }
20 | . container {
21 | display : flex ;
22 | flex - wrap : wrap ;
23 | justify - content : center ;
24 | margin - top : 20 px ;
25 | }
26 | . slider - container {
27 | margin : 20 px ;
28 | text - align : center ;
29 | }
30 | . slider {
31 | width : 300 px ;
32 | margin : 10 px 0;
33 | }
34 | . button {
35 | margin : 10 px ;
36 | padding : 15 px 30 px ;
37 | font - size : 18 px ;
38 | cursor : pointer ;
39 | border : none ;
40 | border - radius : 5 px ;
41 | background - color : #4 caf50 ;
42 | color : white ;
43 | transition : transform 0.2 s , background - color 0.2 s;
44 | }
45 | . button : hover {
46 | background - color : #45 a049 ;
47 | transform : scale (1.05) ;
48 | }
49 | . response {
50 | margin - top : 20 px ;
51 | padding : 10 px ;
52 | background - color : # 282 c34 ;
53 | border - radius : 5 px ;
54 | width : 80 %;
55 | max - width : 500 px ;
56 | margin - left : auto ;
57 | margin - right : auto ;
58 | }
59 | . temperature - box {
60 | margin - top : 20 px ;
61 | padding : 20 px ;
62 | background - color : # 333;
63 | border - radius : 10 px ;
64 | font - size : 24 px ;
65 | font - weight : bold ;
66 | }
67 | . chart - container {
68 | width : 80 %;

Página 22 de 32

69 | max - width : 800 px ;
70 | margin : 20 px auto ;
71 | }
72 | </ style >
73 | < script >
74 | function sendAction ( action , value = null ) {
75 | fetch ("/", {
76 | method : " POST ",
77 | headers : { " Content - Type ": " application / json " },
78 | body : JSON . stringify ({ action : action , value : value }) ,
79 | })
80 | . then (( response ) => response . json () )
81 | . then (( data ) => {
82 | const responseDiv = document . getElementById (" response ");
83 | responseDiv . innerHTML = ‘<p >${ data . message } </p > ‘;
84 | responseDiv . style . color =
85 | data . status === " success " ? " lightgreen " : " red ";
86 | })
87 | . catch (( error ) => {
88 | const responseDiv = document . getElementById (" response ");
89 | responseDiv . innerHTML = ‘<p > Error de c o n e x i n : ${ error . message } </p > ‘;
90 | responseDiv . style . color = " red ";
91 | }) ;
92 | }

93
94 | function updateSliderValue ( action , sliderId , labelId ) {
95 | const slider = document . getElementById ( sliderId );
96 | const value = slider . value ;
97 | const label = document . getElementById ( labelId );
98 | label . textContent = ‘${ value } ‘; // Actualiza el texto sin duplicar " %"
99 | sendAction ( action , parseInt ( value )); // E n v a el valor al servidor
100 | }

101
102 | function updateTemperature () {
103 | fetch ("/", {
104 | method : " POST ",
105 | headers : { " Content - Type ": " application / json " },
106 | body : JSON . stringify ({ action : " temperatura ", value : 0 }) ,
107 | })
108 | . then (( response ) => response . json () )
109 | . then (( data ) => {
110 | if (
111 | data . status === " success " &&
112 | data . message . startsWith (" Temperatura promedio ")
113 | ) {
114 | const tempBox = document . getElementById (" temperature -box");
115 | tempBox . textContent = data . message ;
116 | }
117 | })
118 | . catch (( error ) => {
119 | const tempBox = document . getElementById (" temperature -box ");
120 | tempBox . textContent = " Error obteniendo temperatura ";
121 | }) ;
122 | }

123
124 | function sendSetValue () {
125 | const value = document . getElementById (" setpoint "). value ;
126 | sendAction (" set_value ", parseFloat ( value ) );
127 | }
128 | function setFoco () {
129 | const focoInput = document . getElementById ("foco - input "). value ;
130 | const potencia = parseFloat ( focoInput ) ;

131
132 | if (! isNaN ( potencia ) && potencia >= 0 && potencia <= 100) {
133 | sendAction (" foco ", potencia ); // E n v a el valor al servidor
134 | } else {
135 | alert (" Por favor , introduce un valor v l i d o entre 0 y 100. ");
136 | }
137 | }

138

Página 23 de 32

139 | function updateCharts () {
140 | document . getElementById (" temperatureChart "). src =
141 | "/ temperature - chart ?" + new Date () . getTime () ;
142 | document . getElementById (" actionChart "). src =
143 | "/ action - chart ?" + new Date () . getTime () ;
144 | }

145
146 | window . onload = function () {
147 | updateCharts () ;
148 | };

149
150 | // Actualiza las g r f i c a s cada minuto
151 | setInterval ( updateCharts , 60000) ;

152
153 | // Llama inicial para que la temperatura se muestre al cargar la p g i n a
154 | document . addEventListener (" DOMContentLoaded ", updateTemperature );
155 | </ script >
156 | </ head >
157 | <body >
158 | <h1 > Panel de Control </ h1 >
159 | <h2 > Temperatura Actual </ h2 >
160 | < div id=" temperature - box " class =" temperature - box ">
161 | Obteniendo temperatura ...
162 | </ div >
163 | <h2 > Control de Motores </ h2 >
164 | < div class =" container ">
165 | < div class =" slider - container ">
166 | < label for =" motor1 - slider "> Motor Derecho </ label >
167 | <input
168 | id=" motor1 - slider "
169 | class =" slider "
170 | type =" range "
171 | min ="0"
172 | max =" 100 "
173 | step ="1"
174 | oninput =" updateSliderValue (’ motor_derecho ’, ’motor1 - slider ’, ’motor1 - value ’)"
175 | />
176 | <p > Potencia : < span id="motor1 - value " >50 </ span > %</p >
177 | </ div >
178 | < div class =" slider - container ">
179 | < label for =" motor2 - slider "> Motor Izquierdo </ label >
180 | <input
181 | id=" motor2 - slider "
182 | class =" slider "
183 | type =" range "
184 | min ="0"
185 | max =" 100 "
186 | step ="1"
187 | oninput =" updateSliderValue (’ motor_izquierdo ’, ’motor2 - slider ’, ’motor2 - value ’)
| "
188 | />
189 | <p > Potencia : < span id="motor2 - value " >50 </ span > %</p >
190 | </ div >
191 | </ div >
192 | <h2 > Control de Ambos Motores </ h2 >
193 | < div class =" container ">
194 | < div class =" slider - container ">
195 | < label for ="ambos - slider "> Ambos Motores </ label >
196 | <input
197 | id="ambos - slider "
198 | class =" slider "
199 | type =" range "
200 | min ="0"
201 | max =" 100 "
202 | step ="1"
203 | oninput =" updateSliderValue (’ ambos_motores ’, ’ambos - slider ’, ’ambos - value ’)"
204 | />
205 | <p > Potencia : < span id="ambos - value " >70 </ span > %</p >
206 | </ div >
207 | </ div >

Página 24 de 32

208 | <h2 > Control del Foco </ h2 >
209 | < div class =" container ">
210 | < div class ="input - container ">
211 | < label for ="foco - input "> Foco ( Potencia 0 -100 %) </ label >
212 | <input
213 | type =" number "
214 | id="foco - input "
215 | placeholder ="0 -100"
216 | min ="0"
217 | max =" 100 "
218 | style ="
219 | padding : 10 px;
220 | font - size : 16 px;
221 | width : 150 px;
222 | margin - right : 10 px;
223 | "
224 | />
225 | < button class =" button " onclick =" setFoco ()"> Definir </ button >
226 | </ div >
227 | </ div >
228 | <h2 > Otros Controles </ h2 >
229 | < div class =" container ">
230 | < button class =" button " onclick =" sendAction (’ bomba ’, 1)">
231 | Encender Bomba
232 | </ button >
233 | < button class =" button " onclick =" sendAction (’ bomba ’, 0)">
234 | Apagar Bomba
235 | </ button >
236 | < button class =" button " onclick =" sendAction (’ set_pid ’, 30)">
237 | PID (30 C )
238 | </ button >
239 | </ div >
240 | <h2 > Modo Predeterminado </ h2 >
241 | < button class =" button " onclick =" sendAction (’ predeterminado ’)">
242 | Activar Modo Predeterminado
243 | </ button >
244 | <h2 > Establecer Temperatura </ h2 >
245 | < div class =" container ">
246 | <input
247 | type =" number "
248 | id=" setpoint "
249 | placeholder =" Setpoint | C "
250 | min ="0"
251 | max =" 100 "
252 | style =" padding : 10 px; font - size : 16 px; width : 150 px; margin - right : 10 px"
253 | />
254 | < button class =" button " onclick =" sendSetValue ()">
255 | Establecer Setpoint
256 | </ button >
257 | </ div >
258 | < div class ="chart - container ">
259 | < img
260 | id=" temperatureChart "
261 | src ="/ temperature - chart "
262 | alt =" G r f i c a de Temperatura "
263 | />
264 | </ div >
265 | < div class ="chart - container ">
266 | < img id=" actionChart " src ="/action - chart " alt =" G r f i c a de Acciones " / >
267 | </ div >
268 | < div id=" response " class =" response " > </ div >
269 | </ body >
270 | </ html >

Página 25 de 32

## D. Programa Main

1 | from http . server import BaseHTTPRequestHandler , HTTPServer
2 | import json
3 | import signal
4 | import sys
5 | import threading
6 | import time
7 | from datetime import datetime , timedelta
8 | from control import motor_derecho , motor_izquierdo , ambos_motore , bomba , potencia_foco ,
set_PID , temperatura , cleanup , predeterminado , set_value
9 import matplotlib . pyplot as plt

10
11 | HOST = " 0.0.0.0 "
12 | PORT = 8080

13
14 | # Variable global para almacenar la temperatura
15 | current_temperature = {" average ": None }

16
17 | # F u n c i n para actualizar la temperatura p e r i d i c a m e n t e en un hilo
18 | def update_temperature () :
19 | """
20 | Hilo en segundo plano que actualiza la temperatura cada 5 segundos .
21 | """
22 | global current_temperature
23 | while True :
24 | try :
25 | temp = temperatura () | # Llama a la f u n c i n para leer la temperatura
26 | if temp is not None :
27 | current_temperature [" average "] = temp
28 | print (f"[ Hilo Temperatura ] Temperatura actualizada : { temp :.2 f} C ")
29 | else :
30 | current_temperature [" average "] = None
31 | print ("[ Hilo Temperatura ] No se pudo obtener una temperatura v l i d a .")
32 | except Exception as e:
33 | print (f"[ Hilo Temperatura ] Error actualizando la temperatura : {e}")
34 | current_temperature [" average "] = None | # Manejo e x p l c i t o de errores
35 | time . sleep (5) | # Espera 5 segundos antes de la siguiente lectura

36
37 | def log_action ( action , message ) :
38 | """
39 | F u n c i n para registrar las acciones en una b i t c o r a .
40 | """
41 | with open (’ bitacora_acciones . txt ’, ’a’) as log_file :
42 | timestamp = time . strftime (" %Y- %m- %d %H: %M: %S")
43 | log_file . write (f"{ timestamp } - A c c i n : { action } - { message }\n")

44
45 | def read_log_file ( file_path , time_limit ) :
46 | """
47 | Lee un archivo de b i t c o r a y devuelve los registros dentro del l m i t e de tiempo
| especificado .
48 | """
49 | data = {" timestamps ": [] , " values ": []}
50 | time_limit = datetime . now () - timedelta ( minutes = time_limit )
51 | with open ( file_path , ’r’) as log_file :
52 | for line in log_file :
53 | timestamp_str , value = line . split (" - ") [0] , line . split (" - ") [ -1]
54 | timestamp = datetime . strptime ( timestamp_str , " %Y- %m- %d %H: %M: %S")
55 | if timestamp >= time_limit :
56 | data [" timestamps "]. append ( timestamp_str )
57 | data [" values "]. append ( value . strip () )
58 | return data

59
60 | def generate_temperature_chart () :
61 | """
62 | Genera una g r f i c a de temperatura de los | ltimos | 5 minutos y la guarda como imagen
63 | """
64 | data = read_log_file (’ BitacoraTemp . txt ’, 5)
65 | timestamps = data [" timestamps "]

Página 26 de 32

66 | temperatures = [ float ( value . split (": ") [1]. replace (" C ", "")) for value in data ["
values "]]

67
68 | plt . figure ( figsize =(10 , 5) )
69 | plt . plot ( timestamps , temperatures , marker =’o’)
70 | plt . title (’ Temperatura de los | ltimos | 5 minutos ’)
71 | plt . xlabel (’Tiempo ’)
72 | plt . ylabel (’Temperatura ( C )’)
73 | plt . xticks ( rotation =45)
74 | plt . tight_layout ()
75 | plt . savefig (’ temperature_chart . png ’)
76 | plt . close ()

77
78 | def generate_action_chart () :
79 | """
80 | Genera una g r f i c a de acciones de los | ltimos | 5 minutos y la guarda como imagen .
81 | """
82 | data = read_log_file (’ bitacora_acciones . txt ’, 5)
83 | timestamps = data [" timestamps "]
84 | actions = data [" values "]

85
86 | plt . figure ( figsize =(10 , 5) )
87 | plt . bar ( timestamps , range ( len ( actions )) , tick_label = actions )
88 | plt . title (’Acciones de los | ltimos | 5 minutos ’)
89 | plt . xlabel (’Tiempo ’)
90 | plt . ylabel (’Acciones ’)
91 | plt . xticks ( rotation =45)
92 | plt . tight_layout ()
93 | plt . savefig (’ action_chart . png ’)
94 | plt . close ()

95
96 | class RequestHandler ( BaseHTTPRequestHandler ):
97 | def do_GET ( self ):
98 | if self . path == "/":
99 | self . send_response (200)
100 | self . send_header (" Content - type ", " text / html ")
101 | self . end_headers ()
102 | with open (" interface . html ", "r") as file :
103 | self . wfile . write ( file . read () . encode ("utf -8") )
104 | elif self . path == "/ temperature - chart ":
105 | self . send_response (200)
106 | self . send_header (" Content - type ", " image / png ")
107 | self . end_headers ()
108 | with open (" temperature_chart . png", "rb") as file :
109 | self . wfile . write ( file . read () )
110 | elif self . path == "/ action - chart ":
111 | self . send_response (200)
112 | self . send_header (" Content - type ", " image / png ")
113 | self . end_headers ()
114 | with open (" action_chart . png ", "rb") as file :
115 | self . wfile . write ( file . read () )
116 | elif self . path == "/ temperature - data ":
117 | self . send_response (200)
118 | self . send_header (" Content - type ", " application / json ")
119 | self . end_headers ()
120 | data = read_log_file (’ BitacoraTemp . txt ’, 5)
121 | temperatures = [ float ( value . split (": ") [1]. replace (" C ", "")) for value in
data [" values "]]
122 | response_data = {" timestamps ": data [" timestamps "], " temperatures ":
temperatures }
123 | self . wfile . write ( json . dumps ( response_data ). encode ("utf -8") )
124 | elif self . path == "/ action - data ":
125 | self . send_response (200)
126 | self . send_header (" Content - type ", " application / json ")
127 | self . end_headers ()
128 | data = read_log_file (’ bitacora_acciones . txt ’, 5)
129 | actions = [ value for value in data [" values "]]
130 | response_data = {" timestamps ": data [" timestamps "], " actions ": actions }
131 | self . wfile . write ( json . dumps ( response_data ). encode ("utf -8") )
132 | else :

Página 27 de 32

133 | self . send_error (404 , " Archivo no encontrado .")

134
135 | def do_POST ( self ):
136 | content_length = int ( self . headers . get (’Content - Length ’, 0) )
137 | post_data = self . rfile . read ( content_length )
138 | try :
139 | data = json . loads ( post_data . decode ("utf -8"))
140 | action = data . get (" action ")
141 | value = data . get (" value ")

142
143 | response_data = {" status ": " success "}

144
145 | # Manejo de acciones
146 | if action == " motor_derecho ":
147 | motor_derecho ( value )
148 | message = f" Motor derecho ajustado al { value} %"
149 | response_data [" message "] = message
150 | elif action == " motor_izquierdo ":
151 | motor_izquierdo ( value )
152 | message = f" Motor izquierdo ajustado al { value} %"
153 | response_data [" message "] = message
154 | elif action == " ambos_motores ":
155 | ambos_motore ( value )
156 | message = f" Ambos motores ajustados al { value} %"
157 | response_data [" message "] = message
158 | elif action == " bomba ":
159 | bomba ( value )
160 | message = " Bomba encendida " if value == 1 else " Bomba apagada "
161 | response_data [" message "] = message
162 | elif action == " foco ":
163 | potencia_foco ( value )
164 | message = f" Foco ajustado al { value} % de potencia "
165 | response_data [" message "] = message
166 | elif action == " set_pid ":
167 | set_PID ( value )
168 | message = f" PID ajustado a { value } C "
169 | response_data [" message "] = message
170 | elif action == " temperatura ":
171 | # Devuelve la temperatura almacenada en la variable global
172 | temp = current_temperature [" average "]
173 | message = f" Temperatura promedio : { temp :.2f} C " if temp is not None
| else " Temperatura no disponible "
174 | response_data [" message "] = message

175
176 | # Nuevas funcionalidades
177 | elif action == " predeterminado ":
178 | predeterminado ()
179 | message = " Modo predeterminado activado "
180 | response_data [" message "] = message
181 | elif action == " set_value ":
182 | temp = value
183 | set_value ( temp )
184 | message = f" Setpoint configurado a { temp } C "
185 | response_data [" message "] = message

186
187 | else :
188 | raise ValueError (" A c c i n no reconocida ")

189
190 | # Registrar la a c c i n en la b i t c o r a
191 | log_action ( action , message )

192
193 | # Respuesta HTTP exitosa
194 | self . send_response (200)
195 | self . send_header (" Content - type ", " application / json ")
196 | self . end_headers ()
197 | self . wfile . write ( json . dumps ( response_data ). encode ("utf -8") )
198 | except Exception as e:
199 | # Respuesta en caso de error
200 | self . send_response (500)
201 | self . send_header (" Content - type ", " application / json ")

Página 28 de 32

202 | self . end_headers ()
203 | self . wfile . write ( json . dumps ({" status ": " error ", " message ": str( e) }) . encode ("
| utf -8"))

204
205 | def cleanup_and_exit ( server ):
206 | """
207 | F u n c i n para cerrar el servidor y liberar recursos de forma segura .
208 | """
209 | print ("\ nCerrando servidor y limpiando recursos ...")
210 | try :
211 | cleanup () | # Limpia los pines GPIO en el archivo control .py
212 | except Exception as e:
213 | print (f" Error durante la limpieza : {e}")
214 | finally :
215 | server . server_close () | # Cierra el servidor HTTP
216 | print (" Servidor detenido y recursos limpiados . | Adis | !")
217 | sys . exit (0)

218
219 | def signal_handler ( sig , frame ):
220 | """
221 | Captura s e a l e s como CTRL +C y llama a la limpieza segura .
222 | """
223 | cleanup_and_exit ( httpd )

224
225 | if __name__ == " __main__ ":
226 | # Inicia el hilo para actualizar la temperatura
227 | temperature_thread = threading . Thread ( target = update_temperature , daemon = True )
228 | temperature_thread . start ()

229
230 | # Captura la s e a l SIGINT ( CTRL +C) para limpiar y salir de forma segura
231 | signal . signal ( signal . SIGINT , signal_handler )

232
233 | # Inicia el servidor HTTP
234 | httpd = HTTPServer (( HOST , PORT ) , RequestHandler )
235 | print (f" Servidor iniciado en http ://{ HOST }:{ PORT }")

236
237 | # Genera las g r f i c a s cada minuto
238 | def generate_charts_periodically () :
239 | while True :
240 | generate_temperature_chart ()
241 | generate_action_chart ()
242 | time . sleep (60)

243
244 | chart_thread = threading . Thread ( target = generate_charts_periodically , daemon = True )
245 | chart_thread . start ()

246
247 | try :
248 | # Mantiene el servidor corriendo
249 | httpd . serve_forever ()
250 | except KeyboardInterrupt :
251 | cleanup_and_exit ( httpd )
252 | except Exception as e:
253 | print (f" Error inesperado : {e}")
254 | cleanup_and_exit ( httpd )

Página 29 de 32

## E. Programa motor PWM

1 import RPi . GPIO as GPIO

2
3 | GPIO . setwarnings ( False ) | # Desactiva advertencias de GPIO
4 | GPIO . cleanup () | # Limpia los recursos previos
5 | GPIO . setmode ( GPIO . BCM )

6
7 | def setup_motor ( pin , frequency =250) :
8 | """
9 | Configura el pin como salida PWM para controlar el motor .

10
11 | Args :
12 | pin : Pin GPIO conectado al motor .
13 | frequency : Frecuencia del PWM (en Hz).

14
15 | Returns :
16 | pwm : Objeto PWM inicializado .
17 | """
18 | GPIO . setup ( pin , GPIO . OUT )
19 | pwm = GPIO . PWM ( pin , frequency )
20 | pwm . start (0)
21 | return pwm

22
23 | def set_motor_power ( pwm , power ) :
24 | """
25 | Ajusta la potencia del motor .

26
27 | Args :
28 | pwm : Objeto PWM configurado .
29 | power : Potencia en porcentaje (0 -100) .
30 | """
31 | if 0 <= power <= 100:
32 | pwm . ChangeDutyCycle ( power )
33 | else :
34 | print (" Error : La potencia debe estar entre 0 y 100. ")

35
36 | def cleanup () :
37 | """
38 | Limpia los pines GPIO .
39 | """
40 | GPIO . cleanup ()

Página 30 de 32

## F. Programa PID

1 | import smbus2
2 | import struct
3 | import time
4 | from Temperature import read_temperature

5
6 | SLAVE_ADDR = 0 x0A
7 | i2c = smbus2 . SMBus (1)

8
9 | class PIDController :
10 | def __init__ ( self , kp =3.0 , ki =2.5 , kd =1.5) :
11 | self . Kp = kp
12 | self . Ki = ki
13 | self . Kd = kd
14 | self . integral = 0
15 | self . previous_error = 0
16 | self . last_time = time . time ()

17
18 | def calculate ( self , setpoint , actual_value ) :
19 | current_time = time . time ()
20 | dt = current_time - self . last_time
21 | self . last_time = current_time

22
23 | error = setpoint - actual_value
24 | self . integral += error * dt
25 | derivative = ( error - self . previous_error ) / dt if dt > 0 else 0

26
27 | output = self . Kp * error + self . Ki * self . integral + self . Kd * derivative
28 | self . previous_error = error

29
30 | output = max (0 , min (100 , output ))
31 | return round ( output )

32
33 | def write_power ( pwr ):
34 | try :
35 | data = struct . pack (’<f’, pwr )
36 | msg = smbus2 . i2c_msg . write ( SLAVE_ADDR , data )
37 | i2c . i2c_rdwr ( msg )
38 | except Exception as e:
39 | print (f" Error en la escritura I2C : {e}")

40
41 | def control_temperature ( setpoint , pid_controller ) :
42 | try :
43 | actual_temp = read_temperature ()
44 | if actual_temp is None :
45 | print ("No se obtuvo una lectura v l i d a . Intentando de nuevo ... ")
46 | return None

47
48 | adjusted_power = pid_controller . calculate ( setpoint , actual_temp )
49 | write_power ( adjusted_power )

50
51 | print (f" Setpoint : { setpoint } C | | Actual : { actual_temp :.2 f} C | | Potencia : {
| adjusted_power} %")
52 | return adjusted_power
53 | except Exception as e:
54 | print (f" Error en el control PID: {e}")
55 | return None

Página 31 de 32

## G. Programa Temperature

1 import time

2
3 | sensor_1 = ’/ sys /bus /w1/ devices /28 -0000096 e37aa / w1_slave ’
4 | sensor_2 = ’/ sys /bus /w1/ devices /28 -80301 e356461 / w1_slave ’
5 | sensor_3 = ’/ sys /bus /w1/ devices /28 -1 e051b356461 / w1_slave ’
6 | sensor_4 = ’/ sys /bus /w1/ devices /28 -0000096 d7bc7 / w1_slave ’

7
8 sensors = [ sensor_1 , sensor_2 , sensor_3 , sensor_4 ]

9
10 | def sensor_temperature ( sensor_file ):
11 | try :
12 | with open ( sensor_file , ’r’) as file :
13 | lines = file . readlines ()

14
15 | if lines [0]. strip () . endswith (’YES ’):
16 | temperature_data = lines [1]. split ("t=")
17 | if len ( temperature_data ) == 2:
18 | temperature_c = float ( temperature_data [1]) / 1000.0
19 | return temperature_c
20 | except FileNotFoundError :
21 | return " Sensor no encontrado "
22 | except Exception as e:
23 | return f" Error : {e}"
24 | return " Lectura fallida "

25
26 | def average ( temperatures ):
27 | sum = 0
28 | for i in temperatures :
29 | sum += i
30 | return sum / len( temperatures )

31
32 | def log_temperature ( temperature ) :
33 | with open (’ BitacoraTemp . txt ’, ’a’) as log_file :
34 | timestamp = time . strftime (" %Y- %m- %d %H: %M: %S")
35 | log_file . write (f"{ timestamp } - Temperatura : { temperature :.2 f} C \n")

36
37 | def read_temperature () :
38 | temps = []
39 | for i in sensors :
40 | temp = sensor_temperature (i )
41 | if isinstance ( temp , float ):
42 | temps . append ( temp )
43 | avg_temp = average ( temps )
44 | print ( temps )
45 | log_temperature ( avg_temp )
46 | return avg_temp

47
48 print ( read_temperature () )

Página 32 de 32
