FriasCamille/proyecto_final_invernadero/vid/readme.md

# Link del video

[Haz clic aquí para ver el video](https://youtu.be/c8E_DXlMjes?si=FF8OjmhhxgGFfNOu)

---
