FriasCamille/proyecto_final_invernadero/structure/planos_invernadero.pdf

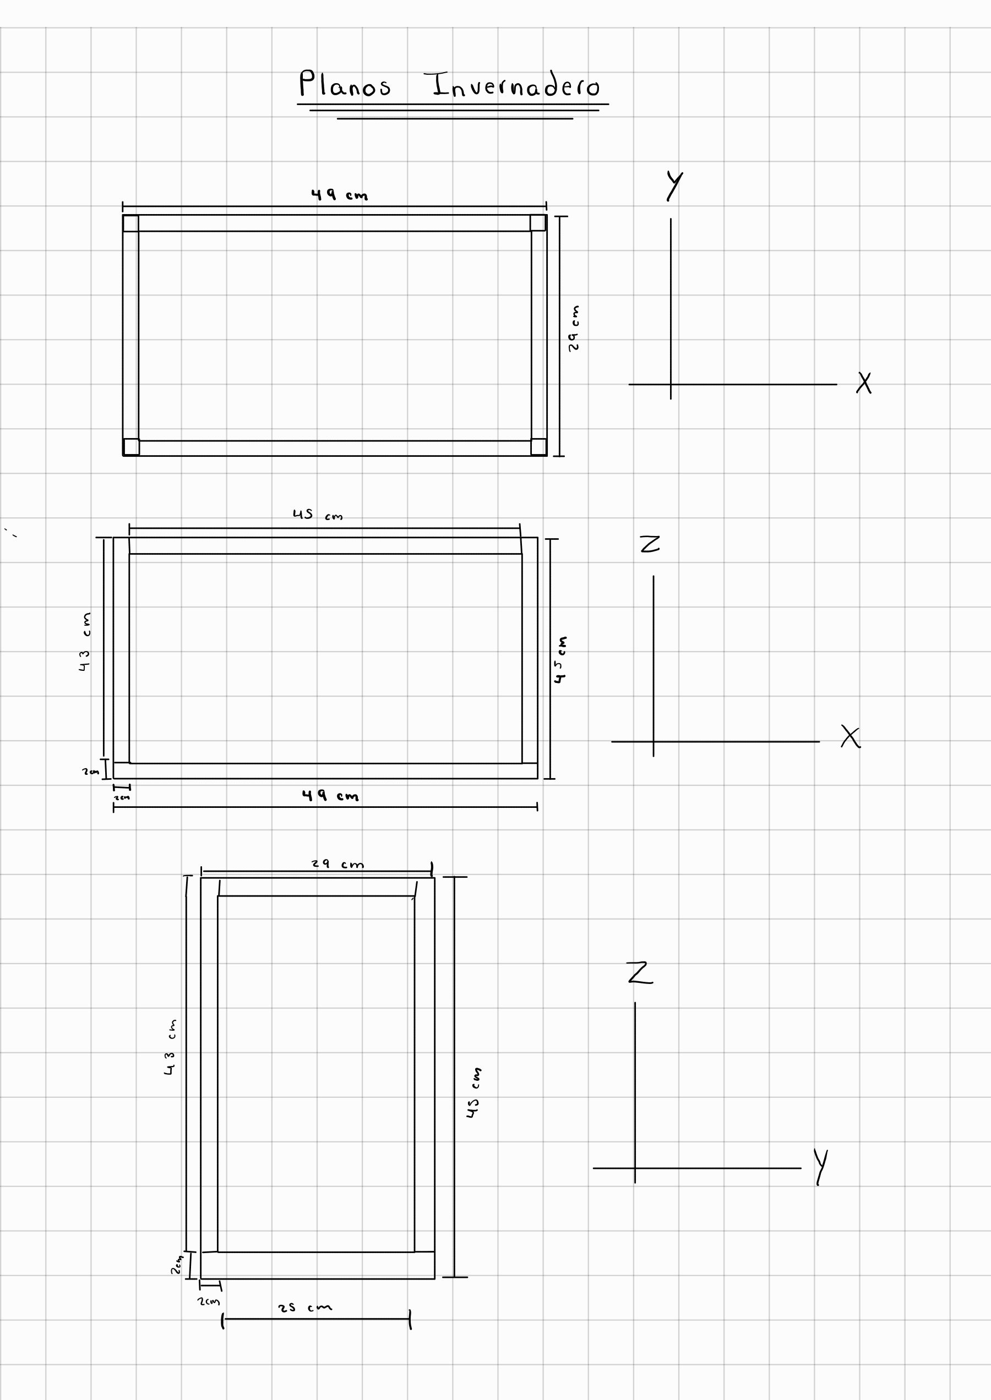
[picture p4: page 1]
