FriasCamille/proyecto_final_invernadero/hardware/kicad/control_invernadero/control_invernadero.kicad_pcb

## KiCad design Muondetector.kicad_sch

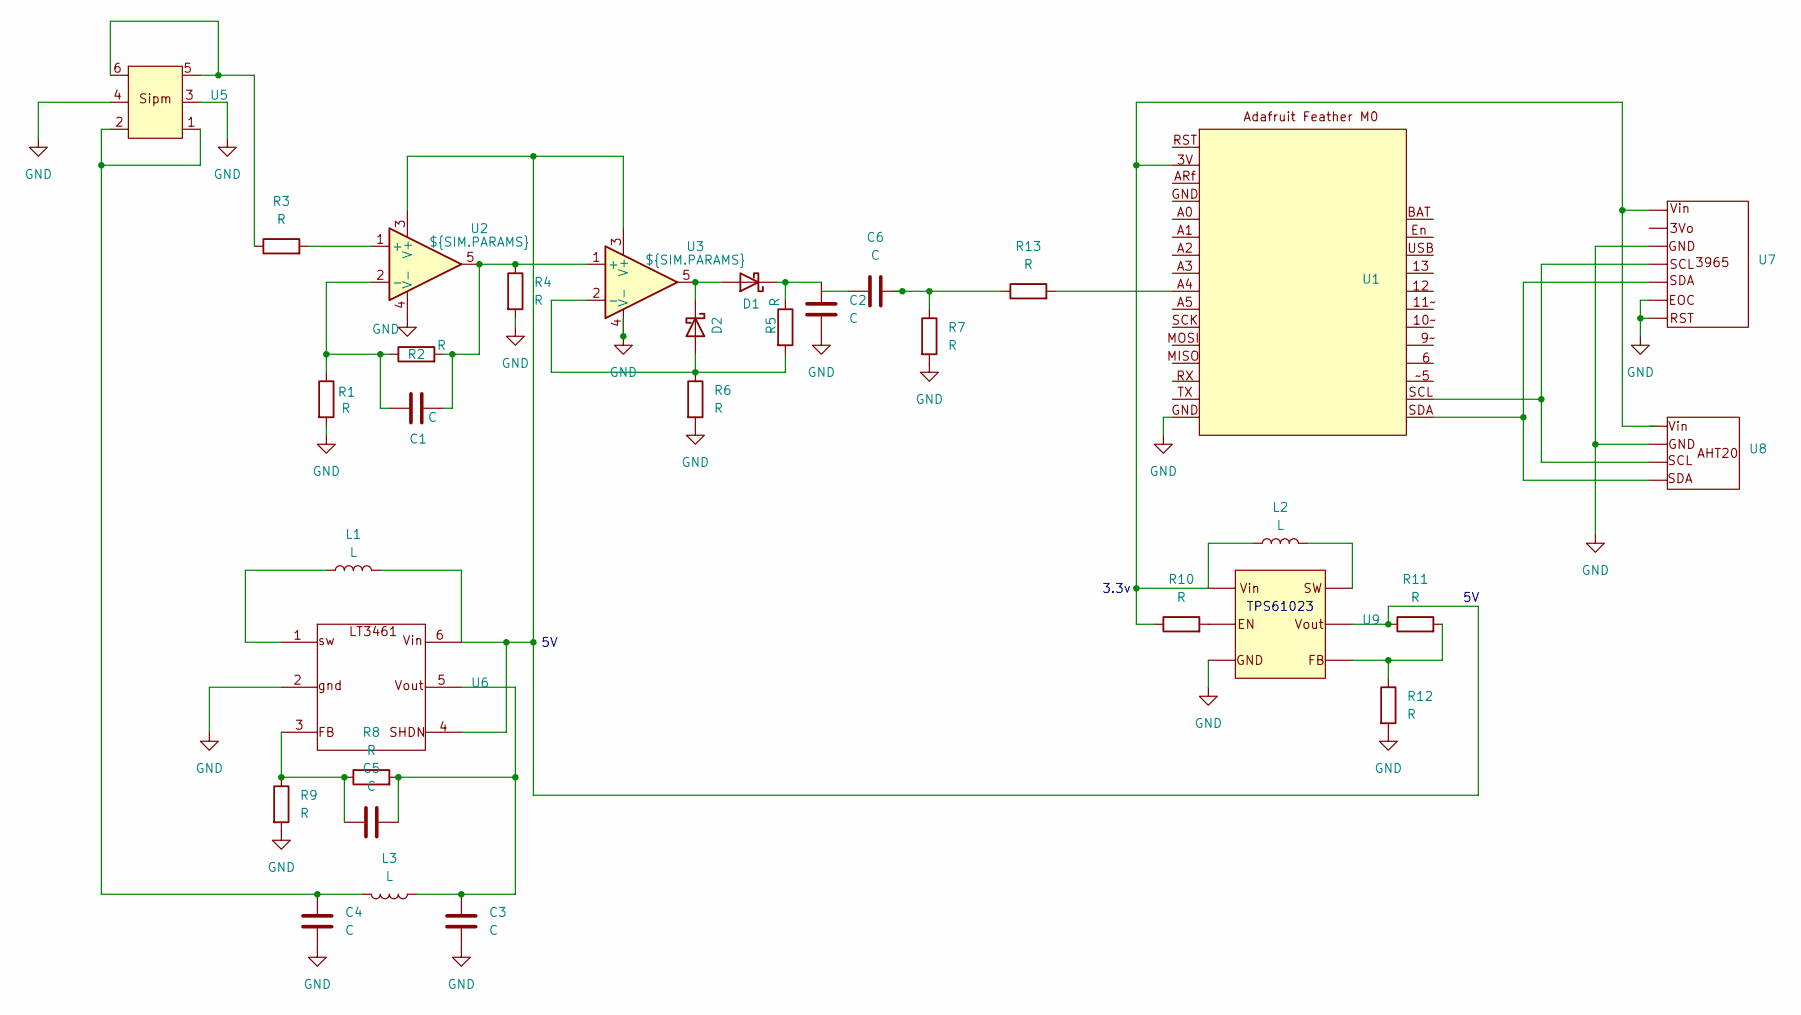
[picture p5: schematic Muondetector.kicad_sch]

Parts:
C1, C2, C3, C4, C5, C6: C
D1, D2: D_DO-41_SOD81_P10.16mm_Horizontal
L1, L2, L3: L
R1, R2, R3, R4, R5, R6, R7, R8, R9, R10, R11, R12, R13: R
U1, U5, U6, U7, U8, U9: (no value)
U2, U3: ${SIM.PARAMS}

Connections:
GND: C2.2, C3.2, C4.2, R1.2, R4.2, R6.2, R7.2, R9.2, R12.2, U2.4 (V-), U3.4 (V-)
unnamed: C1.1, R1.1, R2.1, U2.2 (-)
unnamed: C1.2, R2.2, R4.1, U2.5, U3.1 (+)
unnamed: C2.1, D1.1 (K), R5.1
unnamed: C3.1, C5.2, L3.1, R8.2
unnamed: C4.1, L3.2
unnamed: C5.1, R8.1, R9.1
unnamed: C6.2, R7.1, R13.1
unnamed: D1.2 (A), D2.1 (K), U3.5
unnamed: D2.2 (A), R5.2, R6.1, U3.2 (-)
unnamed: L1.2, R11.1, U2.3 (V+), U3.3 (V+)
unnamed: L2.1, R10.1
unnamed: R3.2, U2.1 (+)
unnamed: R11.2, R12.1

Notes on the sheet:
3.3v
TPS61023
