FriasCamille/proyecto_final_invernadero/(commit log)

2024-11-13 Create README.md
    Se creó el readme con los datos, se pondrán a futuro los objetivos del proyecto y las partes que contiene.
2024-11-13 Corrigiendo el formato del readme
2024-11-14 Añadiendo carpeta de evidencias con imágenes
    Se ha agregado una carpeta llamada "Evidencias" en el directorio "registro" que contiene imágenes relacionadas con el proyecto.
2024-11-14 se añadio la primer evidencia
2024-11-14 se añadieron evidencias de construcción
2024-11-14 Comandos para los colaboradores del equipo
2024-11-14 DescripciĆ³n de los cambios realizados
2024-11-14 Creacion del simulado del proyecto en PROTEUS
    [Nuevo proyecto [20241114, 10-40-39].pdsprj, Nuevo proyecto.pdsprj]
2024-11-15 Se agrega esquematico en kicad del circuito total
    [control_invernadero.kicad_pcb, control_invernadero.kicad_sch]
2024-11-20 Se agregan nodos de prueba para los circuitos de motores y sensores
2024-11-21 Actualización de imagenes de evidencias
2024-11-22 añadiendo sensor de humedad
    el código ya lee la humedad máxima, mínima y adecuada para el riego
2024-11-23 Esquematico actualizado
    [control_invernadero.kicad_sch]
2024-11-23 Código de prueba del foco y Documentación Final
2024-11-23 Código de control PWM de los motores y acomodo de codigos de prueba
2024-11-24 Se suben codigo PID y actualización del esquemático
    [control_invernadero.kicad_sch]
2024-11-24 Código de index.html para el servidor web
2024-11-24 continuación de pruebas del invernadero
2024-11-25 Se suben implementaciones de las funciones para ser llamadas facilmente y comportamiento general del invernadero
2024-11-25 se agrego el control de irrigación
2024-11-25 prueba 17 fallo en la irrigación
2024-11-25 Borrando texto para crear carpeta
2024-11-25 Versión 2 del Servidor Web y el html
2024-11-25 Hoja de estilo para el servidor y actualizacion para poder asignar la temperatura
2024-11-25 Sintonización de constantes y arrelgo de lógica
2024-11-25 Prueba de servidores 1
2024-11-25 Prueba de servidores 2
2024-11-25 Prueba de servidores 3
2024-11-25 Prueba de servidores 4
2024-11-25 Prueba de servidores 5
2024-11-25 Prueba de servidores 6
2024-11-25 Prueba de servidores 7
2024-11-25 Prueba de servidores 8
2024-11-25 Prueba de servidores 10
2024-11-25 Prueba de servidores 11
2024-11-25 Prueba de servidores 12
2024-11-25 Prueba de servidores 13
2024-11-25 Prueba de servidores 14
2024-11-25 Prueba de servidores 15
2024-11-25 Prueba de servidores 16
2024-11-25 Prueba de servidores 17
2024-11-25 Prueba de servidores 18
2024-11-25 Prueba de servidores 19
2024-11-26 Prueba de servidores 20
2024-11-26 Prueba de servidores 21
2024-11-26 Prueba de servidores 22, motores PWM integrados
2024-11-26 Códigos actualizados de pruebas
2024-11-27 Se agrego la licencia MIT al repositorio
2024-11-27 Eliminación de códigos de prueba
2024-11-27 Se quitó una carpeta
    [Nuevo proyecto [20241114, 10-40-39].pdsprj, Nuevo proyecto.pdsprj]
